bereniich/TempSens/README.md

# Temperature Sensing System of HV Battery
Temperature Sensing System of HV Battery in vehicle produced by Formula Student team "Black Hornets" from the University of Novi Sad.
