bereniich/TempSens/hardware/TempSens.kicad_pcb

## KiCad design hardware/TempSens.kicad_pcb (2026-04-25)

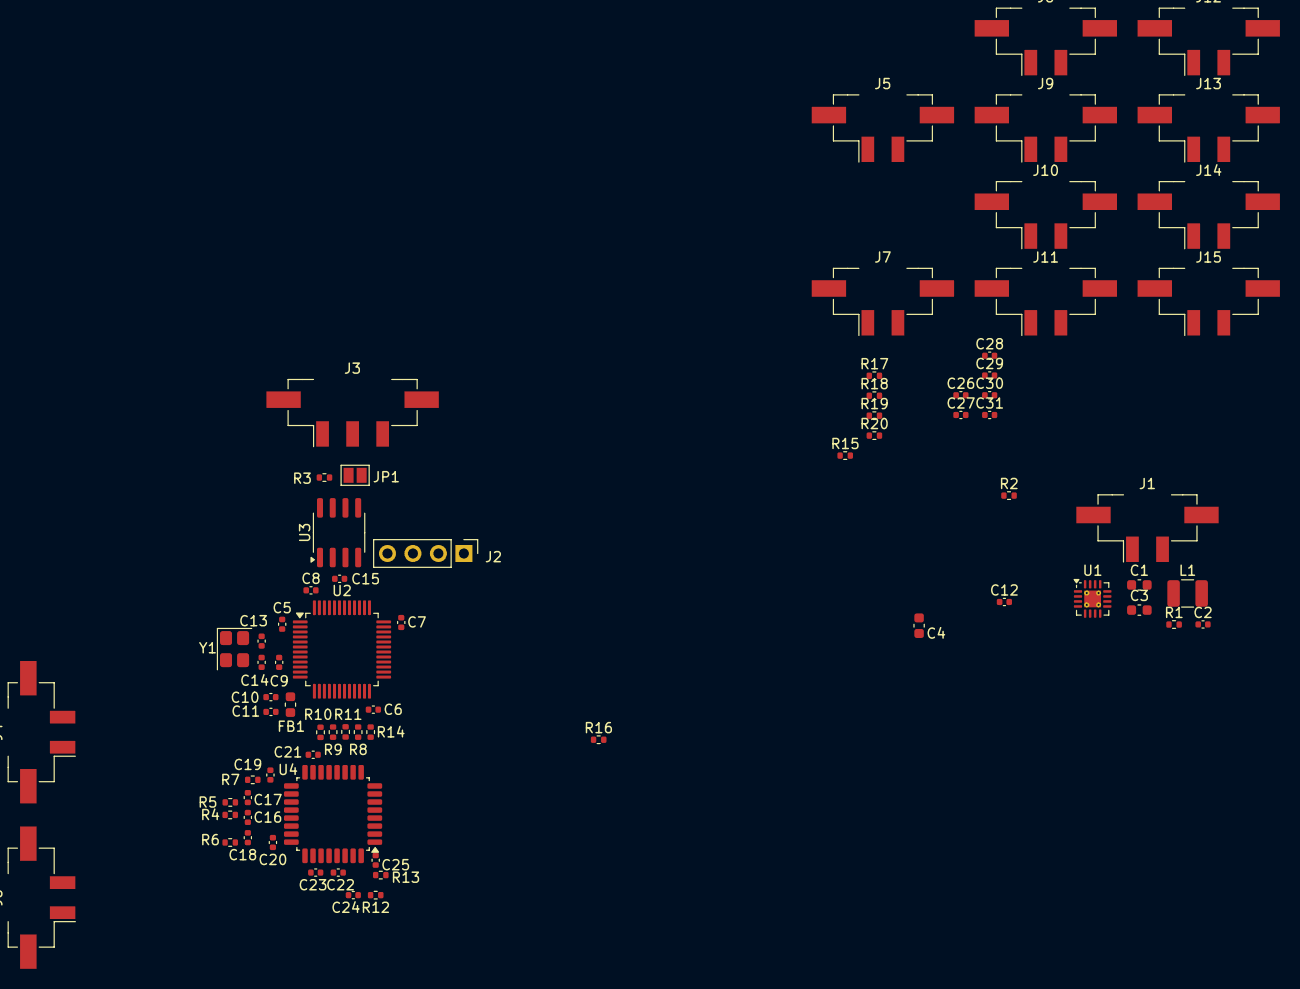
[picture p4: board TempSens.kicad_pcb from above]

Board: 2 copper layers, 74 parts (0 on the bottom side), 52 nets, no tracks yet.

Parts:
C1, C4: 10u; C_0603_1608Metric
C2: 3.2n; C_0402_1005Metric
C3: 22u; C_0603_1608Metric
C5, C6, C7, C8, C12, C15: 100n; C_0402_1005Metric
C9: 10n; C_0402_1005Metric
C10, C11, C20, C21, C22: 1u; C_0402_1005Metric
C13, C14: 10p; C_0402_1005Metric
C16, C17, C18, C19, C23, C24, C25, C26, C27, C28, C29, C30, C31: 330n; C_0402_1005Metric
FB1: FerriteBead; L_0603_1608Metric
J1, J4, J5, J6, J7, J8, J9, J10, J11, J12, J13, J14, J15: Conn_01x02_Pin; Molex_Micro-Fit_3.0_43650-0224_1x02-1MP_P3.00mm_Vertical
J2: Conn_01x04_Pin; PinHeader_1x04_P2.54mm_Vertical
J3: Conn_01x03_Pin; Molex_Micro-Fit_3.0_43650-0324_1x03-1MP_P3.00mm_Vertical
JP1: Jumper_2_Open; SolderJumper-2_P1.3mm_Open_Pad1.0x1.5mm
L1: 2.2u; L_1210_3225Metric
R1: 100k; R_0402_1005Metric
R2: 10k; R_0402_1005Metric
R3: 120; R_0402_1005Metric
R4, R5, R6, R7, R12, R13, R15, R16, R17, R18, R19, R20: 4.7k; R_0402_1005Metric
R8, R9, R10, R11, R14: 47; R_0402_1005Metric
U1: TPS62152; VQFN-16-1EP_3x3mm_P0.5mm_EP1.68x1.68mm_ThermalVias
U2: STM32F103C8T6; LQFP-48_7x7mm_P0.5mm
U3: SN65HVD232; SOIC-8_3.9x4.9mm_P1.27mm
U4: ADS114S08B; TQFP-32_7x7mm_P0.8mm
Y1: 16MHz; Crystal_SMD_3225-4Pin_3.2x2.5mm

Connections:
+3.3V: C3.1, C4.1, C5.1, C6.1, C7.1, C8.1, C11.1, C15.1, C21.1, C22.1, C23.1, FB1.2, J2.1, L1.2, R1.1, U1.14 (VOS), U2.1 (VBAT), U2.24 (VDD), U2.36 (VDD), U2.48 (VDD), U3.3 (VCC), U4.15 (IOVDD), U4.16 (DVDD), U4.26 (AVDD), U4.30 (REFN0)
+3.3VA: C9.1, C10.1, FB1.1, U2.9 (VDDA)
/adc_rc/RESET: R8.2, U2.19 (PB1)
/adc_rc/SPI_MISO: R9.1, U2.16 (PA6)
/adc_rc/SPI_MOSI: R11.2, U2.17 (PA7)
/adc_rc/SPI_SCLK: R10.2, U2.15 (PA5)
/adc_rc/START_SYNC: R14.2, U2.20 (PB2)
/mcu_can/BOOT0: R2.2, U2.44 (BOOT0)
/mcu_can/CAN_H: J3.1, R3.1, U3.7 (CANH)
/mcu_can/CAN_L: J3.2, JP1.2 (B), U3.6 (CANL)
/mcu_can/CAN_RX: U2.45 (PB8), U3.4 (R)
/mcu_can/CAN_TX: U2.46 (PB9), U3.1 (D)
/mcu_can/HSE_IN: C13.1, U2.5 (PD0), Y1.1
/mcu_can/HSE_OUT: C14.1, U2.6 (PD1), Y1.3
/mcu_can/NRST: C12.2, U2.7 (NRST)
/mcu_can/SWCLK: J2.3, U2.37 (PA14)
/mcu_can/SWDIO: J2.2, U2.34 (PA13)
GND: C1.2, C2.2, C3.2, C4.2, C5.2, C6.2, C7.2, C8.2, C9.2, C10.2, C11.2, C12.1, C13.2, C14.2, C15.2, C16.2, C17.2, C18.2, C19.2, C20.2, C21.2, C22.2, C23.2, C24.2, C25.2, C26.2, C27.2, C28.2, C29.2, C30.2, C31.2, J1.2, J2.4, J3.3, J4.2, J5.2, J6.2, J7.2, J8.2, J9.2, J10.2, J11.2, J12.2, J13.2, J14.2, J15.2, R2.1, U1.5 (FB), U1.6 (GND), U1.7 (FSW), U1.8 (DEF), U1.9 (SS/TR), U1.15 (GND), U1.16 (GND), U1.17 (GND), U2.8 (VSSA), U2.23 (VSS), U2.35 (VSS), U2.47 (VSS), U3.2 (GND), U4.1 (AINCOM), U4.9 (~CS), U4.14 (DGND), U4.17 (CLK), U4.24 (REFCOM), U4.27 (AVSS), U4.28 (AVSS), U4.29 (REFN0), Y1.2, Y1.4
unnamed: C1.1, C2.1, J1.1, U1.10 (VIN), U1.11 (VIN), U1.12 (VIN), U1.13 (EN)
unnamed: J4.1, R4.1
unnamed: J5.1, R5.1
unnamed: J6.1, R6.1
unnamed: J7.1, R7.1
unnamed: J8.1, R12.1
unnamed: J9.1, R13.1
unnamed: J10.1, R15.1
unnamed: J11.1, R16.1
unnamed: J12.1, R17.1
unnamed: J13.1, R18.1
unnamed: J14.1, R19.1
unnamed: J15.1, R20.1
unnamed: JP1.1 (A), R3.2
unnamed: L1.1, U1.1 (SW), U1.2 (SW), U1.3 (SW)
unnamed: R1.2, U1.4 (PG)
unnamed: C27.1, R16.2, U4.7 (AIN0)
unnamed: C29.1, R18.2, U4.6 (AIN1)
unnamed: C31.1, R20.2, U4.5 (AIN2)
unnamed: C30.1, R19.2, U4.4 (AIN3)
unnamed: C28.1, R17.2, U4.3 (AIN4)
unnamed: C26.1, R15.2, U4.2 (AIN5)
unnamed: R11.1, U4.10 (DIN)
unnamed: R9.2, U4.12 (DOUT/~DRDY)
unnamed: C18.1, R6.2, U4.22 (GPIO0/AIN8)
unnamed: C16.1, R4.2, U4.21 (GPIO1/AIN9)
unnamed: C17.1, R5.2, U4.20 (GPIO2/AIN10)
unnamed: C19.1, R7.2, U4.19 (GPIO3/AIN11)
unnamed: C24.1, R12.2, U4.31 (REFN1/AIN7)
unnamed: C20.1, U4.23 (REFOUT)
unnamed: C25.1, R13.2, U4.32 (REFP1/AIN6)
unnamed: R10.1, U4.11 (SCLK)
unnamed: R14.1, U4.8 (START/SYNC)
unnamed: R8.1, U4.18 (~RESET)
