bereniich/TempSens/(commit log)

2026-04-25 Initial clean commit with proper structure
    [TempSens.kicad_pcb, TempSens.kicad_sch, adc_rc.kicad_sch, adc_rc_sch.kicad_sch, mcu_can.kicad_sch]
2026-04-25 Clean project: remove backups and duplicates
    [adc_rc_sch.kicad_sch]
2026-04-25 Added some comments
    [TempSens.kicad_sch]
